DLikely/stm32f3-discovery-arcade/stm32f3disco-arcade-pcb/stm32f3disco-arcade-pcb.kicad_pcb

## KiCad design stm32f3disco-arcade-pcb/stm32f3disco-arcade-pcb.kicad_pcb (2017-09-10)

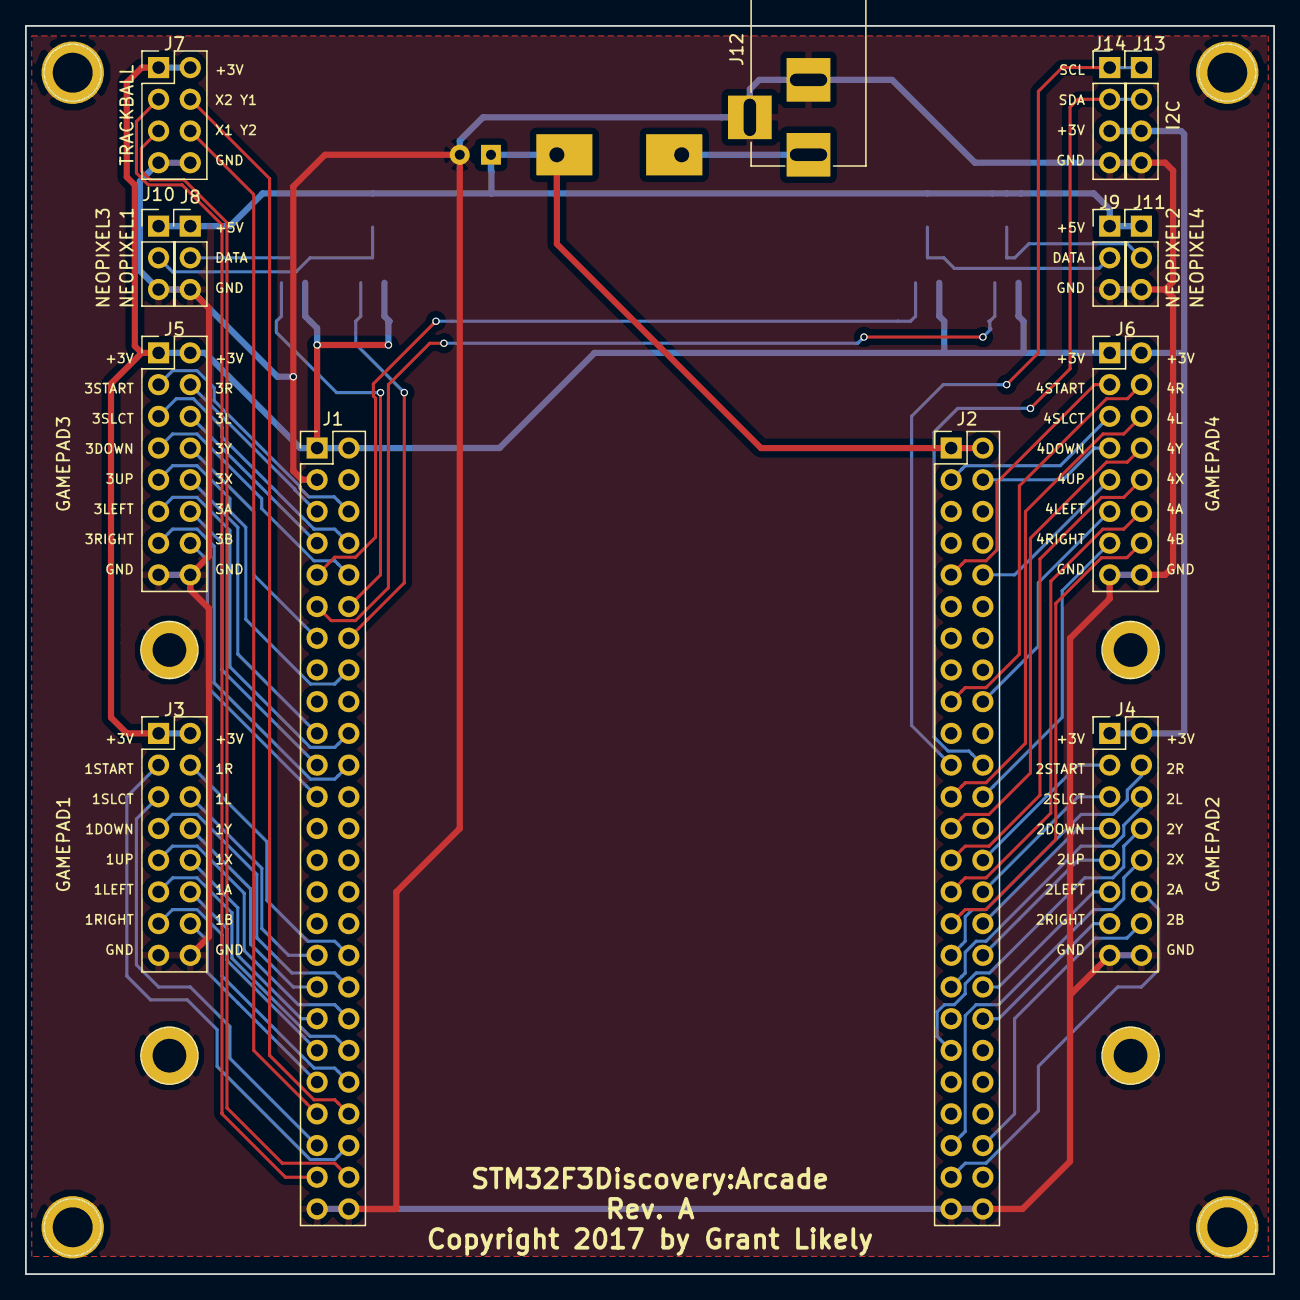
[picture p1: board stm32f3disco-arcade-pcb.kicad_pcb from above]

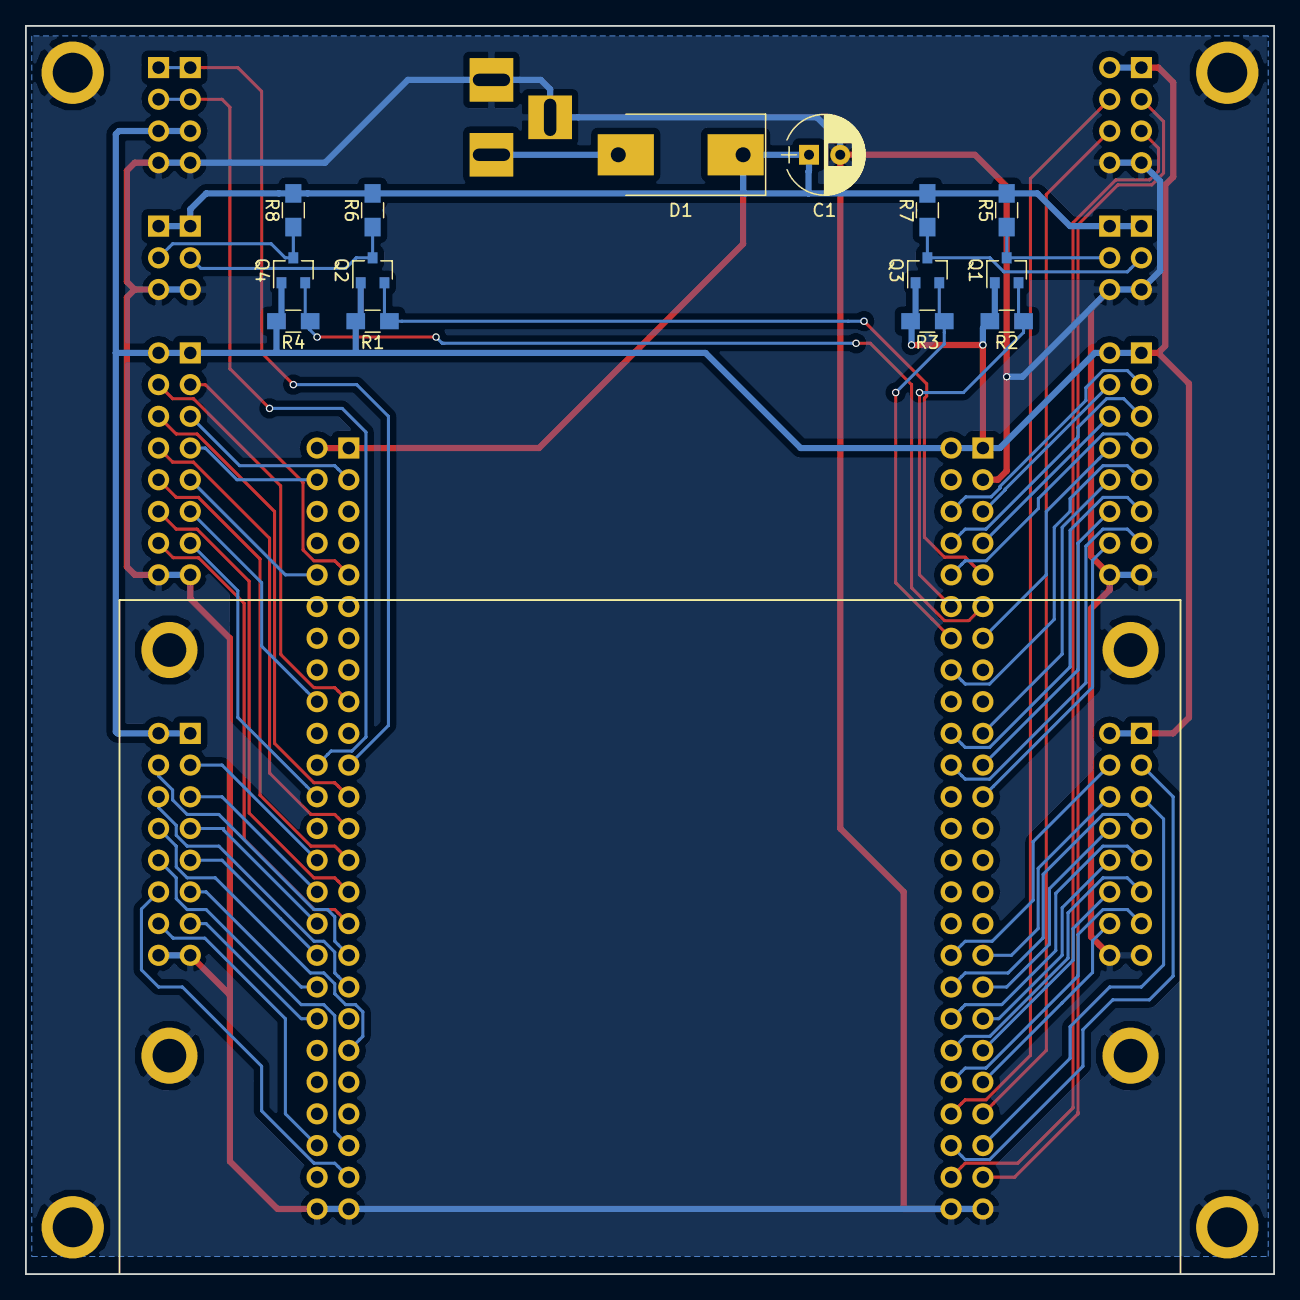
[picture p2: board stm32f3disco-arcade-pcb.kicad_pcb from below]

Board: 2 copper layers, 100.0 x 100.0 mm, 36 parts (14 on the bottom side), 66 nets.

Parts:
C1: 1000uF; CP_Radial_D6.3mm_P2.50mm
D1: D; D_SMC-RM10_Universal_Handsoldering
H1, H2, H3, H4: MountingHole_3.2mm_M3; 1pin
H5, H6, H7, H8: MountingHole_2.7mm_M2.5; 1pin
J1: STM32F3DISCO_P1; Pin_Header_Straight_2x25_Pitch2.54mm
J2: STM32F3DISCO_P2; Pin_Header_Straight_2x25_Pitch2.54mm
J3: GAMEPAD1; Pin_Header_Straight_2x08_Pitch2.54mm
J4: GAMEPAD2; Pin_Header_Straight_2x08_Pitch2.54mm
J5: GAMEPAD3; Pin_Header_Straight_2x08_Pitch2.54mm
J6: GAMEPAD4; Pin_Header_Straight_2x08_Pitch2.54mm
J7: TRACKBALL; Pin_Header_Straight_2x04_Pitch2.54mm
J8: NEOPIXEL1; Pin_Header_Straight_1x03_Pitch2.54mm
J9: NEOPIXEL2; Pin_Header_Straight_1x03_Pitch2.54mm
J10: NEOPIXEL3; Pin_Header_Straight_1x03_Pitch2.54mm
J11: NEOPIXEL4; Pin_Header_Straight_1x03_Pitch2.54mm
J12: BARREL_JACK
J13, J14: I2C; Pin_Header_Straight_1x04_Pitch2.54mm
Q1, Q2, Q3, Q4: BSS138; SOT-23
R1, R2, R3, R4, R5, R6, R7, R8: 10k; R_0805_HandSoldering

Connections:
+3V3: J1.1, J1.2, J3.1, J3.2, J4.1, J4.2, J5.1, J5.2, J6.1, J6.2, J7.1, J7.2, J13.3, J14.3, Q1.1, Q2.1, Q3.1, Q4.1, R1.2, R2.2, R3.2, R4.2
+5V: C1.1, D1.1, J2.1, J2.2, J8.1, J9.1, J10.1, J11.1, R5.2, R6.2, R7.2, R8.2
+5VA: D1.2, J12.1
/P1A: J1.41, J3.14
/P1B: J1.39, J3.12
/P1DOWN: J1.36, J3.7
/P1L: J1.33, J3.6
/P1LEFT: J1.40, J3.11
/P1R: J1.34, J3.4
/P1RIGHT: J1.42, J3.13
/P1SLCT: J1.45, J3.5
/P1STRT: J1.46, J3.3
/P1UP: J1.38, J3.9
/P1X: J1.37, J3.10
/P1Y: J1.35, J3.8
/P2A: J2.46, J4.14
/P2B: J2.47, J4.12
/P2DOWN: J2.32, J4.7
/P2L: J2.35, J4.6
/P2LEFT: J2.36, J4.11
/P2R: J2.33, J4.4
/P2RIGHT: J2.38, J4.13
/P2SLCT: J2.30, J4.5
/P2STRT: J2.28, J4.3
/P2UP: J2.34, J4.9
/P2X: J2.45, J4.10
/P2Y: J2.39, J4.8
/P3A: J1.23, J5.14
/P3B: J1.21, J5.12
/P3DOWN: J1.10, J5.7
/P3L: J1.7, J5.6
/P3LEFT: J1.20, J5.11
/P3R: J1.5, J5.4
/P3RIGHT: J1.22, J5.13
/P3SLCT: J1.8, J5.5
/P3STRT: J1.6, J5.3
/P3UP: J1.16, J5.9
/P3X: J1.19, J5.10
/P3Y: J1.13, J5.8
/P4A: J2.31, J6.14
/P4B: J2.29, J6.12
/P4DOWN: J2.4, J6.7
/P4L: J2.23, J6.6
/P4LEFT: J2.18, J6.11
/P4R: J2.17, J6.4
/P4RIGHT: J2.24, J6.13
/P4SLCT: J2.3, J6.5
/P4STRT: J2.9, J6.3
/P4UP: J2.10, J6.9
/P4X: J2.27, J6.10
/P4Y: J2.25, J6.8
GND: C1.2, H1.1, H2.1, H3.1, H4.1, H5.1, H6.1, H7.1, H8.1, J1.3, J1.49, J1.50, J2.49, J2.50, J3.15, J3.16, J4.15, J4.16, J5.15, J5.16, J6.15, J6.16, J7.7, J7.8, J8.3, J9.3, J10.3, J11.3, J12.2, J12.3, J13.4, J14.4
unnamed: J8.2, Q1.3, R5.1
unnamed: J9.2, Q2.3, R6.1
unnamed: J10.2, Q3.3, R7.1
unnamed: J11.2, Q4.3, R8.1
PWM0: J1.12, Q1.2, R2.1
PWM1: J1.9, Q2.2, R1.1
PWM2: J1.14, Q3.2, R3.1
PWM3: J1.11, Q4.2, R4.1
SCL: J2.21, J13.1, J14.1
SDA: J2.22, J13.2, J14.2
TBALL_X1: J1.48, J7.5
TBALL_X2: J1.47, J7.3
TBALL_Y1: J1.44, J7.4
TBALL_Y2: J1.43, J7.6
