DLikely/stm32f3-discovery-arcade/src/ws2812.h

/* NeoPixel driver library
 *
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
 * Copyright 2017 Grant Likely <grant.likely@secretlab.ca>
 * Parts taken from Adafruit Neopixel library (Also GPLv3 licensed, but no
 * copyright statement in file)
 */

#ifndef __WS2812_H
#define __WS2812_H

// The order of primary colors in the NeoPixel data stream can vary
// among device types, manufacturers and even different revisions of
// the same item.  The third parameter to the Adafruit_NeoPixel
// constructor encodes the per-pixel byte offsets of the red, green
// and blue primaries (plus white, if present) in the data stream --
// the following #defines provide an easier-to-use named version for
// each permutation.  e.g. NEO_GRB indicates a NeoPixel-compatible
// device expecting three bytes per pixel, with the first byte
// containing the green value, second containing red and third
// containing blue.  The in-memory representation of a chain of
// NeoPixels is the same as the data-stream order; no re-ordering of
// bytes is required when issuing data to the chain.

// Bits 5,4 of this value are the offset (0-3) from the first byte of
// a pixel to the location of the red color byte.  Bits 3,2 are the
// green offset and 1,0 are the blue offset.  If it is an RGBW-type
// device (supporting a white primary in addition to R,G,B), bits 7,6
// are the offset to the white byte...otherwise, bits 7,6 are set to
// the same value as 5,4 (red) to indicate an RGB (not RGBW) device.
// i.e. binary representation:
// 0bWWRRGGBB for RGBW devices
// 0bRRRRGGBB for RGB

// RGB NeoPixel permutations; white and red offsets are always same
// Offset:         W          R          G          B
#define NEO_RGB  ((0 << 6) | (0 << 4) | (1 << 2) | (2))
#define NEO_RBG  ((0 << 6) | (0 << 4) | (2 << 2) | (1))
#define NEO_GRB  ((1 << 6) | (1 << 4) | (0 << 2) | (2))
#define NEO_GBR  ((2 << 6) | (2 << 4) | (0 << 2) | (1))
#define NEO_BRG  ((1 << 6) | (1 << 4) | (2 << 2) | (0))
#define NEO_BGR  ((2 << 6) | (2 << 4) | (1 << 2) | (0))

// RGBW NeoPixel permutations; all 4 offsets are distinct
// Offset:         W          R          G          B
#define NEO_WRGB ((0 << 6) | (1 << 4) | (2 << 2) | (3))
#define NEO_WRBG ((0 << 6) | (1 << 4) | (3 << 2) | (2))
#define NEO_WGRB ((0 << 6) | (2 << 4) | (1 << 2) | (3))
#define NEO_WGBR ((0 << 6) | (3 << 4) | (1 << 2) | (2))
#define NEO_WBRG ((0 << 6) | (2 << 4) | (3 << 2) | (1))
#define NEO_WBGR ((0 << 6) | (3 << 4) | (2 << 2) | (1))

#define NEO_RWGB ((1 << 6) | (0 << 4) | (2 << 2) | (3))
#define NEO_RWBG ((1 << 6) | (0 << 4) | (3 << 2) | (2))
#define NEO_RGWB ((2 << 6) | (0 << 4) | (1 << 2) | (3))
#define NEO_RGBW ((3 << 6) | (0 << 4) | (1 << 2) | (2))
#define NEO_RBWG ((2 << 6) | (0 << 4) | (3 << 2) | (1))
#define NEO_RBGW ((3 << 6) | (0 << 4) | (2 << 2) | (1))

#define NEO_GWRB ((1 << 6) | (2 << 4) | (0 << 2) | (3))
#define NEO_GWBR ((1 << 6) | (3 << 4) | (0 << 2) | (2))
#define NEO_GRWB ((2 << 6) | (1 << 4) | (0 << 2) | (3))
#define NEO_GRBW ((3 << 6) | (1 << 4) | (0 << 2) | (2))
#define NEO_GBWR ((2 << 6) | (3 << 4) | (0 << 2) | (1))
#define NEO_GBRW ((3 << 6) | (2 << 4) | (0 << 2) | (1))

#define NEO_BWRG ((1 << 6) | (2 << 4) | (3 << 2) | (0))
#define NEO_BWGR ((1 << 6) | (3 << 4) | (2 << 2) | (0))
#define NEO_BRWG ((2 << 6) | (1 << 4) | (3 << 2) | (0))
#define NEO_BRGW ((3 << 6) | (1 << 4) | (2 << 2) | (0))
#define NEO_BGWR ((2 << 6) | (3 << 4) | (1 << 2) | (0))
#define NEO_BGRW ((3 << 6) | (2 << 4) | (1 << 2) | (0))

#define COLOR(r,g,b,w) (((uint32_t)(w) << 24) | ((uint32_t)(r) << 16) | \
                        ((uint32_t)(g) << 8) | (b))
#define White(c) ((uint8_t)((c >> 24) & 0xFF))
#define Red(c) ((uint8_t)((c >> 16) & 0xFF))
#define Green(c) ((uint8_t)((c >> 8) & 0xFF))
#define Blue(c) ((uint8_t)(c & 0xFF))

struct neopixel {
	uint8_t num_leds;
	uint8_t pixel_width;
	uint8_t *pixels;
	uint8_t r_off, g_off, b_off, w_off; /* Pixel colour offsets */
};

uint8_t color_bright_one(uint8_t c, uint8_t b);
/* Adjust brightness of u32 color.
 * c: RGBW Color in uint32_t format
 * b: brightness where 0xff is full bright, and 0 is off */
uint32_t color_brightness(uint32_t c, uint8_t b);
uint32_t color_wheel(uint8_t angle);

void neopixel_init(struct neopixel *neo, uint8_t format, uint8_t num, uint8_t *pixels);
void neopixel_set_rgbw(struct neopixel *neo, uint8_t n, uint8_t r, uint8_t g, uint8_t b, uint8_t w);
static inline void neopixel_set_rgb(struct neopixel *neo, uint8_t n, uint8_t r, uint8_t g, uint8_t b) {
	neopixel_set_rgbw(neo, n, r, g, b, 0);
}
void neopixel_set_u32(struct neopixel *neo, uint8_t n, uint32_t c);

void ws2812_init(void);
void ws2812_send(uint8_t * p , uint16_t len);


#endif /* __WS2812_H */
