DLikely/stm32f3-discovery-arcade/(commit log)

2017-09-10 Refactor to provide 4 gamepad interfaces
    Refactored the project to be used as an Arcade control panel interface.
    This commit changes it to be a multireport hid device with 4 GPIO
    connected joysticks. Still to be added is a trackball interface and
    control of WS2812 NeoPixels RGB LEDs.
2017-09-10 Fix button assignments and Y axis direction
    The y axis was oriented the wrong way. Positive values mean up, not
    down. Also reorder the buttons to match the Buffalo gamepad. Button
    order is now: A,B,X,Y,L,R,Select,Start.
    [main.c]
2017-09-10 Add trackball support with TIM3/4 quatrature mode
    Enable TIM3 and TIM4 in encoder mode to use as a mouse, and add another
    report ID for the mouse reports. The joystick pins were also moved to
    free up the pins attached to TIM3/4. This change is reflected in main.c
2017-09-10 Initial support for NeoPixel LED illumination
    Add support for NeoPixels attached to TIM2. This patch just associates
    LEDs with buttons and lights the LED when the button is pressed. Next
    step will be to add output reports for setting the LED state.
2017-09-10 Default to button LEDs being on instead of off.
    Change default to light all the LEDs, and to turn them off when the
    associated button is pressed.
2017-09-10 Add PCB KiCad project
    This is an adaptor PCB design for the STM32F3-Discovery board to make
    wiring up arcade controls simpler and tidier, as well as allowing for
    external power.
    [stm32f3disco-arcade-pcb.kicad_pcb, stm32f3disco-arcade-pcb.sch]
2017-09-10 Add mouse click actions
    Make some of the arcade buttons dual purpose by generating mouse click
    events in addition to button presses. This may be a little hacky, but it
    is a reasonable first step. However, this commit exposes a problem with
    the way event reports are handled. Frequently reports get lost which
    results in lost button presses. This will need to be fixed, probably by
    explicitly waiting for the previous USB report to complete sending
    before sending the next one. The code as it stands right now is flat out
    racy.
    [main.c]
2017-09-10 Set button mappings for stm32f3disco-arcade adapter
    The custom arcade adaptor board is being used now and some of the GPIO pin
    mappings have changed. All the LED mappings have changed too as well as
    being changed to SK6812 RGBW modules. Change the button mapping to match
    the hardware.
2017-09-10 Fix UART pin assignment for STM32F3-Discovery
    The STM32F3 Discovery user manual incorrectly says that USART1 is mapped
    to PA9/10. It is not. It is mapped to PC4/5 instead, which requires a
    change to the board design so that USART console output can be used.
    [stm32f3disco-arcade-pcb.sch]
2017-09-10 Update to RGBW NeoPixels
    Fix the code to work for 32-bit RGBW NeoPixels instead of 24-bit RGB.
    This is a hard-coded fix to get RGBW working. Future change will be to
    make the code runtime configurable between 24 and 32 bit pixels.
    [main.c, ws2812.c]
2017-09-10 Fix x-axis polarity on trackball
    It was reversed.
    [main.c]
2017-09-10 Enable all 4 NeoPixel channels
    Enable driving NeoPixels on all 4 NeoPixel outputs, aka all 4 output
    channels of TIM1 in PWM mode. The TIM device supports writing to
    multiple registers on each DMA trigger. The driver uses this to load the
    transmit buffer with PWM values for each of the output pins.
    There is still only one buffer for NeoPixel colour data, but now it is
    divided into 4, with each channel assigned a quarter of the buffer. So,
    Channel 1 gets the first 1/4, Channel 2 gets the second 1/4, etc.
2017-09-10 Add color effect to trackball
    Adds support for illuminating the trackball with a 7-pixel NeoPixel
    'Jewel' daisy chained to end of the player 2 & 4 LED string. As the
    trackball is rolled, the color changes using the common NeoPixel wheel()
    function.
2017-09-10 Add macros to simplify setting LED color and location
    The color and location of buttons can change for each different arcade
    panel build. To make it easier to change the configuration, move the
    values into a new set of #defines at the top of main.c
2017-09-10 Add the Adafruit NeoPixel library to hack on
    The Adafruit NeoPixel library is the most popular API for the pixels,
    and it already supports all the variants. Add the Adafruit code so that
    STM32 support can be added.
2017-09-12 Only refresh gamepad reports when the report can actually be sent
    The gamepad reports were getting refreshed every time through the loop,
    but reports are only generated every 5th time through. To make sure data
    doesn't get dropped, only refresh the report on a cycle when it can
    actually be sent.
    [main.c]
2017-09-12 Fix missed reports bug
    Wait for the previous transfer to complete before kicking off another
    one and fix the wait loop so that the main loop doesn't get stuck
    waiting for a particular value of the DataReady timer counter.
    [main.c]
2017-09-13 Use a VID/DID pair that sets HID_QUIRK_MULTI_REPORT in Linux
    Linux doesn't handle multiple joystick devices well. It tries to make
    the all a single joystick. Use someone elses VID/DID to get the
    multireport quirk turned on when the device is plugged in.
2017-09-13 Fix y axix polarity (again)
    Repeat after me. Up is negative, down is positive.
    Signed-up-by: Grant Likely <grant.likely@secretlab.ca>
    [main.c]
2017-09-16 Fix powerup problem with USB
    Insert a delay on making the USB lines active so that the powerup
    sequence doesn't cause USB to fail to enumerate
    [main.c]
2017-09-17 Handle all of the USB HID protocol
    Implement the rest of the HID protocol so that the device responds
    correctly when the host sets/gets idle, and when it fetches the get
    reports.
2017-09-17 Update USB descriptors to better describe the device
    Little changes to the USB HID descriptor.
    - Change max power to 480mA
    - Update HID Spec version to v1.1
    - Change max report size to 8
2017-09-17 Move things around to get rid of main.h
    Nothing from main.c is called from anywhere else. There is no purpose to
    having a main.h. Move the function declarations out of that file and
    delete it. Also move main() to the bottom of main.c so that it doesn't
    need any forward function declarations either.
    [hw_config.c, main.c]
2017-09-17 Move Accelerometer code to another file
2017-09-19 Move color helpers to ws2812.h
    The color macros are part of the ws2812.c code. Move it out of main.c
    where it doesn't belong.
    [main.c, ws2812.h]
2017-09-19 Store color values in a u32
    Use u32 values for storing colors. A u32 is independent from the pixel
    format, and this code needs to support both RGB and RGBW pixels. Using a
    u32 means the color value doesn't change depending on the pixel type.
    [main.c, ws2812.c]
2017-09-19 Switch to byte-oriented pixel buffer
    Change the code from an array of fixed size pixels to a flat buffer that
    can have the pixels mapped wherever they need to be. This allows both
    RGB and RGBW pixels to be supported at the same time, and even connected
    to the same channel.
    [main.c, ws2812.c, ws2812.h]
2017-09-25 Abstract out neopixel strip properties
    Factor out the neopixel handling that was hard coded into main.c and
    make it a proper set of helper functions. This makes it possible to
    support multiple pixel formats from the same firmware and the main code
    doesn't need to calculate each pixel's offset in the frame buffer.
    [main.c, ws2812.c, ws2812.h]
2017-09-26 Add a simple RGB animations engine
    Add a simple animation engine for the Neopixels. The engine only knows
    how to do two things. It can display each of the player's assigned
    colours, or it can cycle through the rainbow in a variety of patterns.
    Changing modes is accomplished by pressing the P4 "start & select"
    buttons at the same time.
    There is lots of room to improve the display effects, and it would look
    better if all the effects could take into account the assigned player
    colours and the trackball position. It also needs to be extended to
    accept output reports from the host so that the game software can set
    the colours to what it wants.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
