DLikely/stm32f3-discovery-arcade/(notices)

Notices in the files:
src/ws2812.h:
This is free software. You can redistrubute it and/or modify
it under the terms of the GNU Lesser General Public License as
published by the Free Software Foundation, either version 3 of
the License, or (at your option) any later version.
src/ws2812.c:
This program is free software: you can redistribute it and/or modify
it under the terms of the GNU General Public License as published by
the Free Software Foundation, in version 3.
stm32f3disco-arcade-pcb/stm32f3disco-arcade-pcb.kicad_pcb:
Copyright 2017 by Grant Likely
